maduranma/corsair-780t-fan-control-mod/(commit log)

2026-01-07 Fixed indicator LEDs stayed on even when computer was shut down
    [corsair_fan_control_mod.ino]
2026-01-12 Fixed LED blinking did only reset if the last LED was not set
    [corsair_fan_control_mod.ino]
